AveryMinkin724/Self-Balancing-Platform/README.md

# Self-Balancing-Platform
Contains all sprints as part of development of the self balancing platform project

# ICD

# Settings
Uart.c
- choose between Bluetooth or USB mode for UART comms in line 7

imu.c
- choose whether to use hardcoded bias values or run new calibration in line 9
