AveryMinkin724/Self-Balancing-Platform/SBP Chassis/Mag Holder v1.step

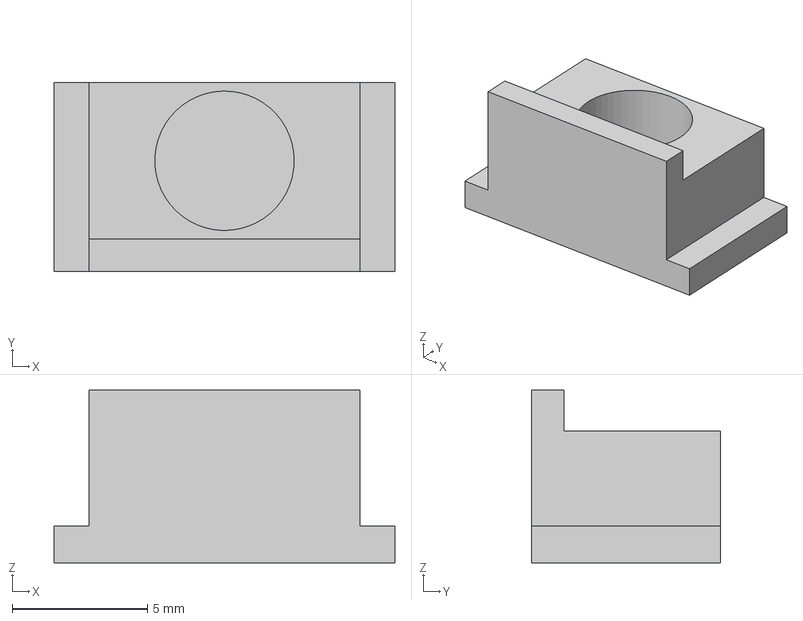
[picture p1: CAD file, 2025-11-26]
SBP Chassis/Mag Holder v1.step
12.6 x 7.00 x 6.38 mm
