AveryMinkin724/Self-Balancing-Platform/SBP Chassis/SBP Chassis v8.step

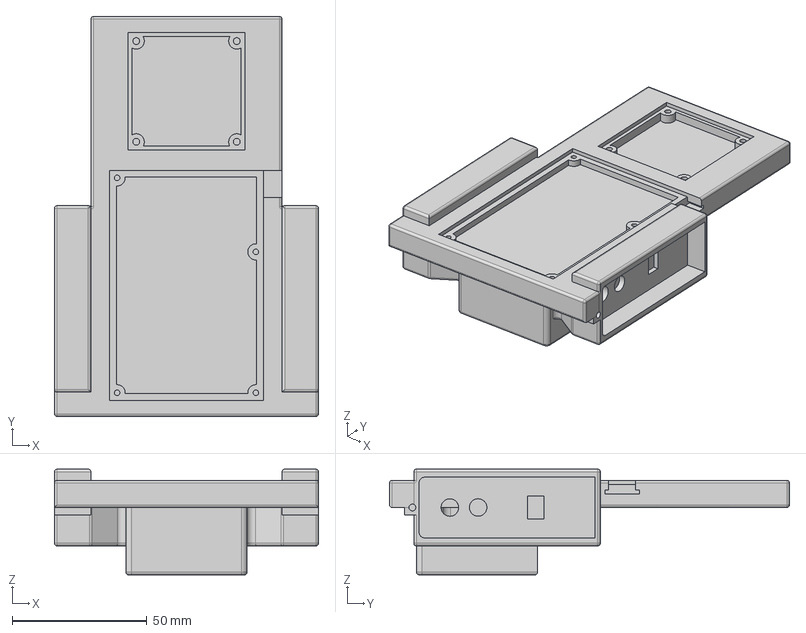
[picture p2: CAD file, 2025-11-26]
SBP Chassis/SBP Chassis v8.step
98.0 x 148.4 x 39.3 mm
