AveryMinkin724/Self-Balancing-Platform/SBP Chassis/xyzCalibration_cube.3mf

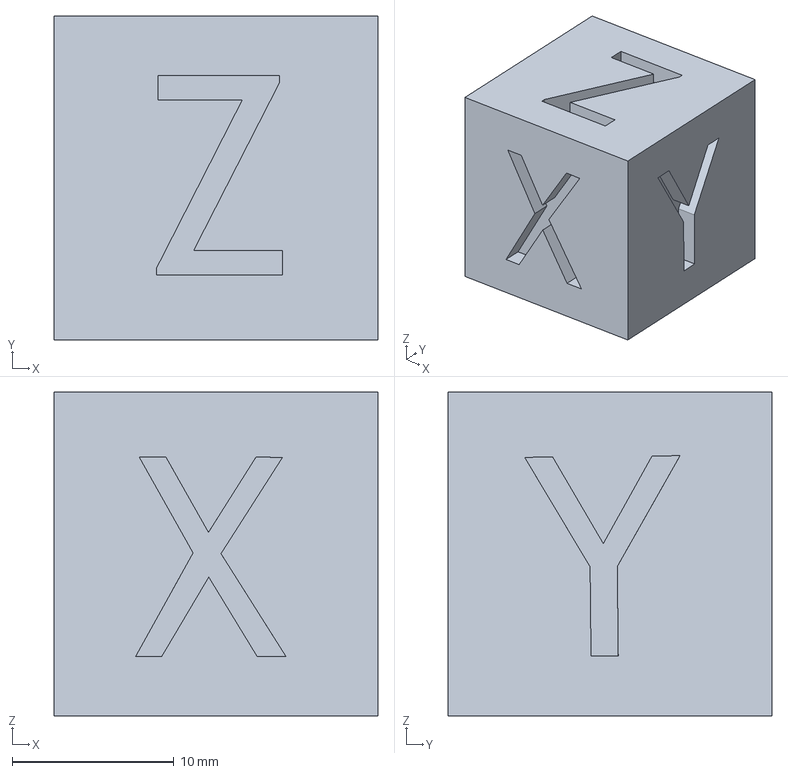
[picture p3: CAD file, 2025-11-26]
SBP Chassis/xyzCalibration_cube.3mf
20.0 x 20.0 x 20.0 mm
