AveryMinkin724/Self-Balancing-Platform/(list of files, cad)

Other CAD files:
SBP Chassis/SBP Chassis v7.step
SBP Chassis/SBP Chassis v7.f3d
SBP Chassis/SBP Chassis v8.3mf
