AveryMinkin724/Self-Balancing-Platform/SBP_Routing_Board/plots/SBP_Routing_Board__Assembly.pdf

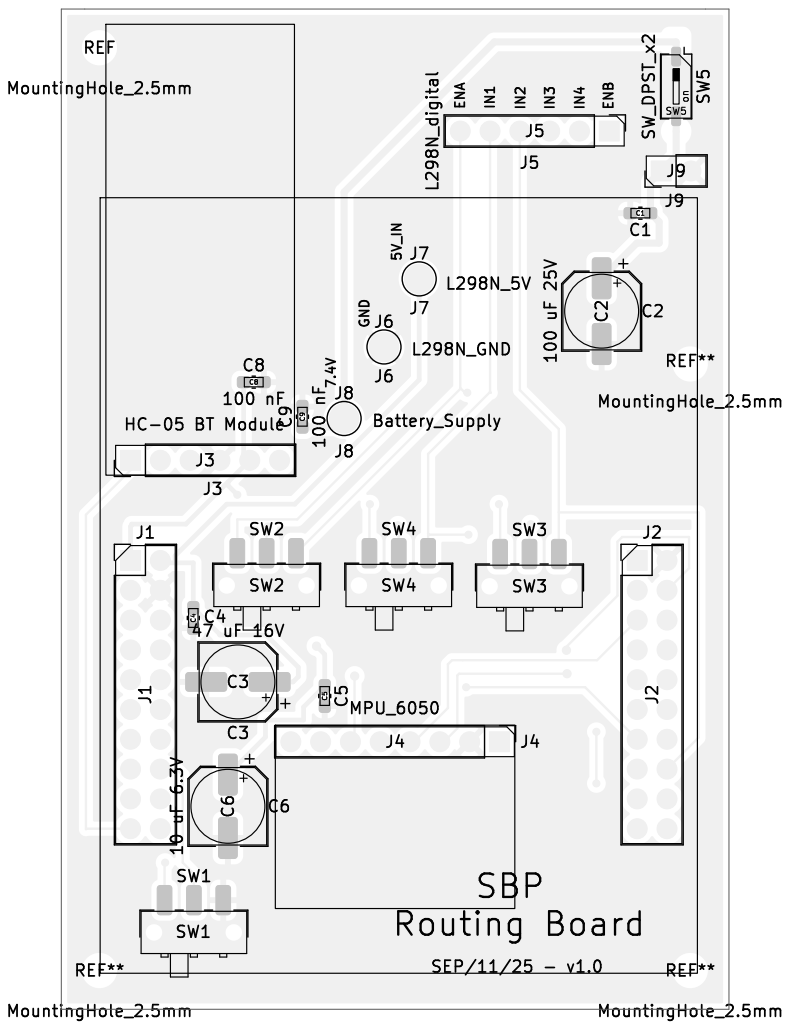
[picture p4: page 1]

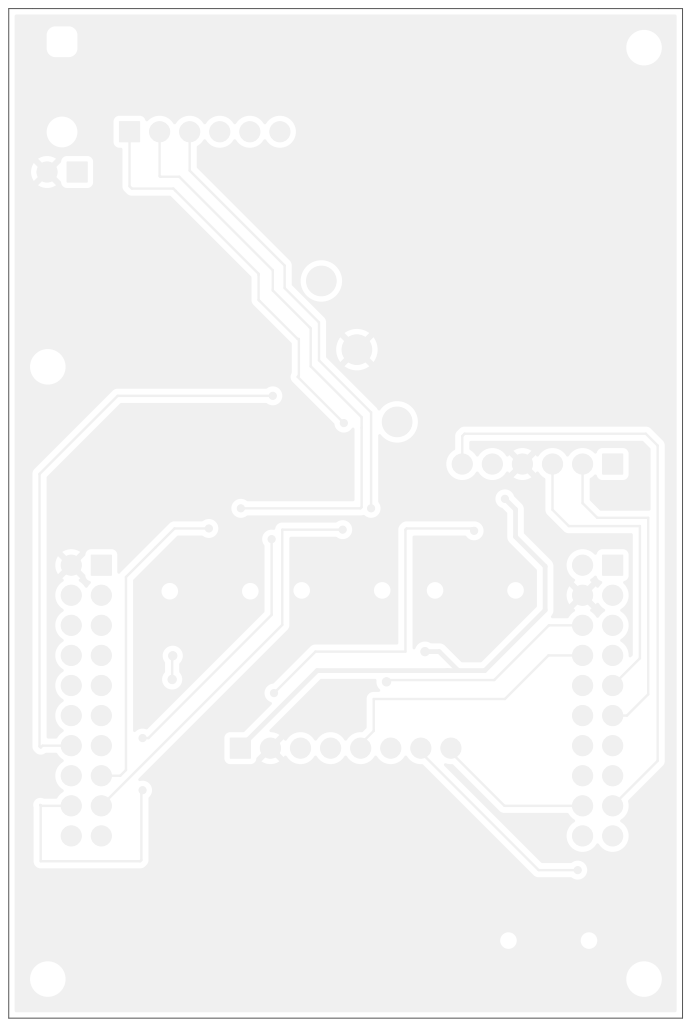
[picture p5: page 2]
D Date: KiCad; E.D.A. 9.0.4 Size: A4; Rev:; Id: /1 Title: File: SBP_Routing_Board.kicad_pcb Sheet: Black; And; White; BOT Board2Pdf:; Black; BOT -; Page 2/2
