AveryMinkin724/Self-Balancing-Platform/SBP_Routing_Board/SBP_Routing_Board_v1.1_schematic.pdf

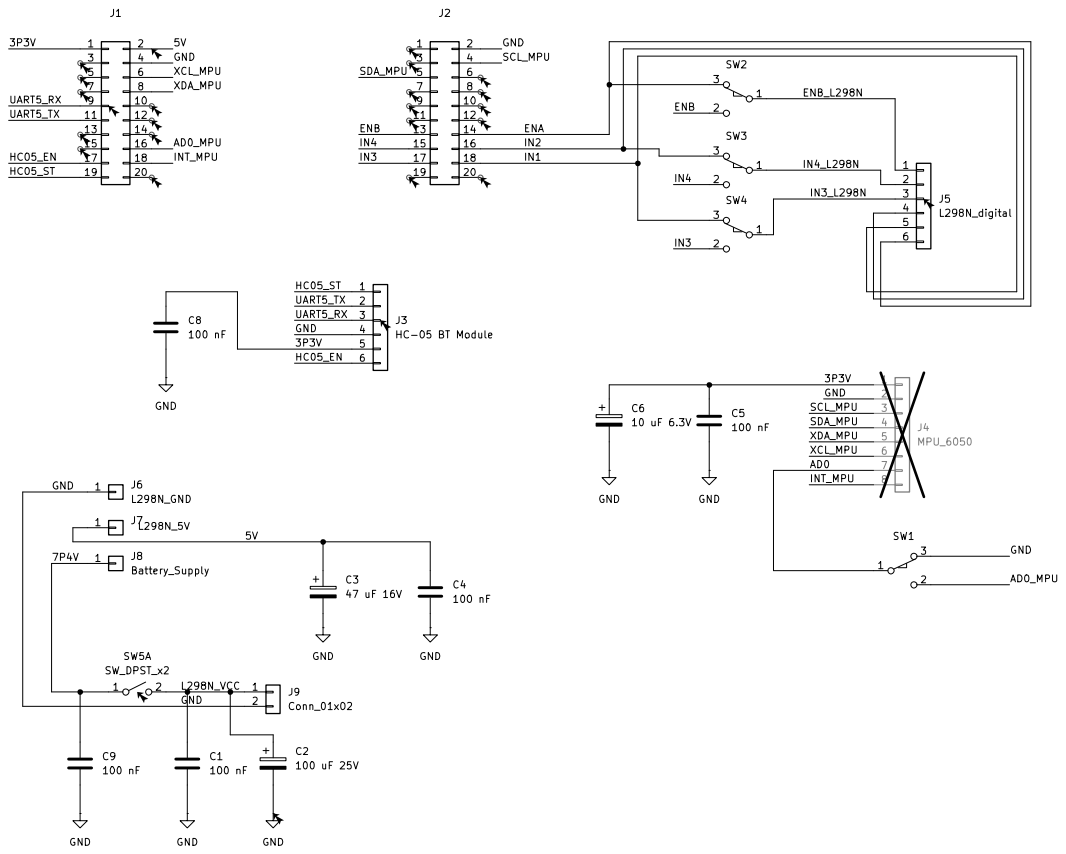
[picture p6: page 1]
