AveryMinkin724/Self-Balancing-Platform/SBP_Routing_Board/SBP_Routing_Board.kicad_pcb

## KiCad design SBP_Routing_Board/SBP_Routing_Board.kicad_pcb (2025-09-28)

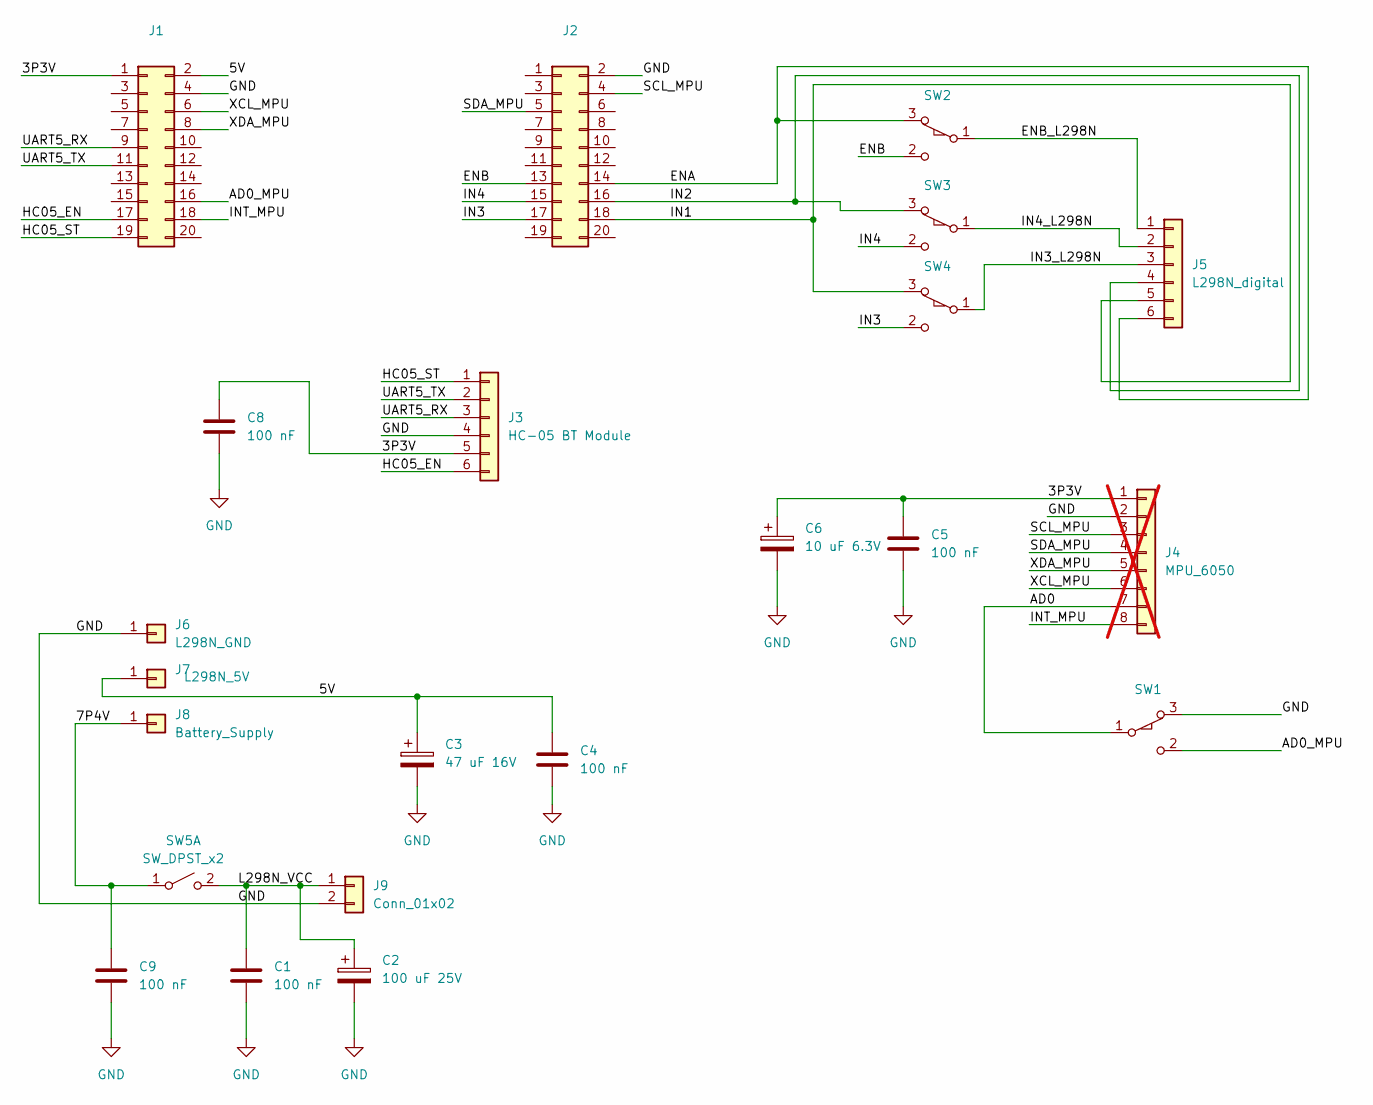
[picture p7: schematic SBP_Routing_Board.kicad_sch]

Parts:
C1, C4, C5, C8, C9: 100 nF; C_0603_1608Metric_Pad1.08x0.95mm_HandSolder
C2: 100 uF 25V; CP_Elec_6.3x5.4
C3: 47 uF 16V; CP_Elec_6.3x5.7
C6: 10 uF 6.3V; CP_Elec_6.3x5.7
J1, J2: Conn_02x10_Odd_Even; PinHeader_2x10_P2.54mm_Vertical
J3: HC-05 BT Module; PinHeader_1x06_P2.54mm_Vertical
J4: MPU_6050; PinHeader_1x08_P2.54mm_Vertical; not fitted
J5: L298N_digital; PinHeader_1x06_P2.54mm_Vertical
J6: L298N_GND; TestPoint_THTPad_D2.5mm_Drill1.2mm
J7: L298N_5V; TestPoint_THTPad_D2.5mm_Drill1.2mm
J8: Battery_Supply; TestPoint_THTPad_D2.5mm_Drill1.2mm
J9: Conn_01x02; PinHeader_1x02_P2.54mm_Vertical
SW1, SW2, SW3, SW4: SW_SPDT_XKB_DMx-xxxx-1; SW_SPDT_CK_JS102011SAQN
SW5: SW_DPST_x2; SW_DIP_SPSTx01_Slide_Copal_CHS-01A_W5.08mm_P1.27mm_JPin

Connections:
/3P3V: C5.1, C6.1, C8.1, J1.1 (3.3V), J3.5 (VCC), J4.1
/5V: C3.1, C4.1, J1.2 (VBUS), J7.1
/7P4V: C9.1, J8.1, SW5.1 (A)
/AD0: J4.7, SW1.1 (A)
/AD0_MPU: J1.16, SW1.2 (B)
/ENA: J2.14, J5.6 (EN), SW2.3 (C)
/ENB: J2.13, SW2.2 (B)
/ENB_L298N: J5.1 (STATE), SW2.1 (A)
/HC05_EN: J1.17 (PA6), J3.6 (EN)
/HC05_ST: J1.19 (PA7), J3.1 (STATE)
/IN1: J2.18, J5.5 (VCC), SW4.3 (C)
/IN2: J2.16, J5.4 (GND), SW3.3 (C)
/IN3: J2.17, SW4.2 (B)
/IN3_L298N: J5.3 (TXD), SW4.1 (A)
/IN4: J2.15, SW3.2 (B)
/IN4_L298N: J5.2 (RXD), SW3.1 (A)
/INT_MPU: J1.18, J4.8
/L298N_VCC: C1.1, C2.1, J9.1, SW5.2 (B)
/SCL_MPU: J2.4, J4.3
/SDA_MPU: J2.5, J4.4
/UART5_RX: J1.9 (PE4), J3.3 (TXD)
/UART5_TX: J1.11 (PE5), J3.2 (RXD)
/XCL_MPU: J1.6, J4.6
/XDA_MPU: J1.8, J4.5
GND: C1.2, C2.2, C3.2, C4.2, C5.2, C6.2, C8.2, C9.2, J1.4 (GND), J2.2, J3.4 (GND), J4.2, J6.1, J9.2, SW1.3 (C)

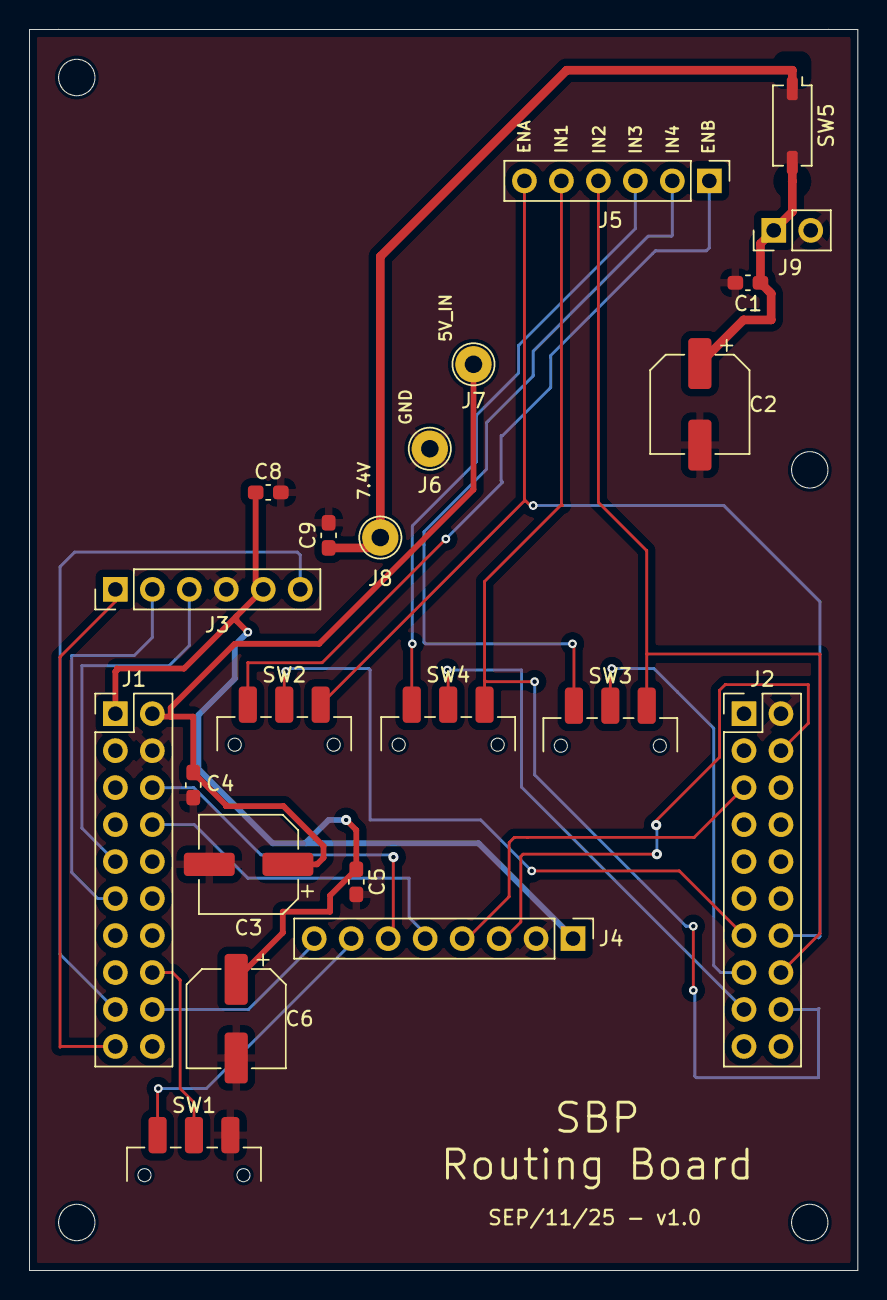
[picture p8: board SBP_Routing_Board.kicad_pcb from above]

Board: 4 copper layers, 56.9 x 85.2 mm, 23 parts (0 on the bottom side), 25 nets.

Other parts of the board:
REF: MountingHole_2.5mm
