AveryMinkin724/Self-Balancing-Platform/Sprint_5_deterministic_timing/motor.h

#ifndef MOTOR_H
#define MOTOR_H

#include <stdint.h>
#include <stdbool.h>
#include "uart.h"
#include "miros.h"
#include "TM4C123GH6PM.h"
#include "bsp.h"
#include "logger.h"
#include "PID.h"
#include "imu.h"

void motor_init(void);
void motor_start(void);
void Task_motor(void);
float clamp(float, float, float);
float apply_deadband(float);

#endif // MOTOR_H
