AveryMinkin724/Self-Balancing-Platform/Sprint_4_Bluetooth Module/bsp.h

#ifndef __BSP_H__
#define __BSP_H__

#include <stdint.h>
#include <stdbool.h>

/* system clock tick [Hz] */
#define BSP_TICKS_PER_SEC 1000U // loop rate = 1000 Hz

void BSP_init(void);
void Clock_init(void);

/* get the current value of the clock tick counter (returns immedately) */
uint32_t BSP_tickCtr(void);

/* delay for a specified number of system clock ticks (polling) */
void BSP_delay(uint32_t ticks);

void BSP_ledRedOn(void);
void BSP_ledRedOff(void);

void BSP_ledBlueOn(void);
void BSP_ledBlueOff(void);

void BSP_ledGreenOn(void);
void BSP_ledGreenOff(void);

extern char uart_rx_buffer[64];
extern volatile bool command_ready;

#endif // __BSP_H__
