AveryMinkin724/Self-Balancing-Platform/(commit log)

2025-06-04 changed 3 task names and print to putty terminal in each task
2025-06-04 added UART Logger Task
2025-06-12 added mmotor task which for now just prints to uart, and motor_init in bsp.c
2025-06-20 added sprint 3 IMU task which just reads MPU6050 ID: 0x68
2025-06-24 added imu calibration
2025-07-11 Added PID control
2025-07-14 PID working with motor task
2025-08-15 UART5_IRQHander working, can send uart messages to tivaC interrupt driven
2025-09-28 Routing Board and Chassis Files Added
    [JLCPCB_BOM.csv, SBP Chassis v6.f3d, SBP Chassis v6.step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]
2025-11-26 operating SBP with PID parameters somewhat tuned
    [Mag Holder v1.step, SBP Chassis v6.f3d, SBP Chassis v6.step, SBP Chassis v7.f3d, SBP Chassis v7.step, SBP Chassis v8.3mf, SBP Chassis v8.step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]
2026-01-31 Adding sprint 5: deterministic timing & clamp on delta_output
